borgel/bolton_buttons/mvp3/Linear-MVP3/Linear-MVP3.step

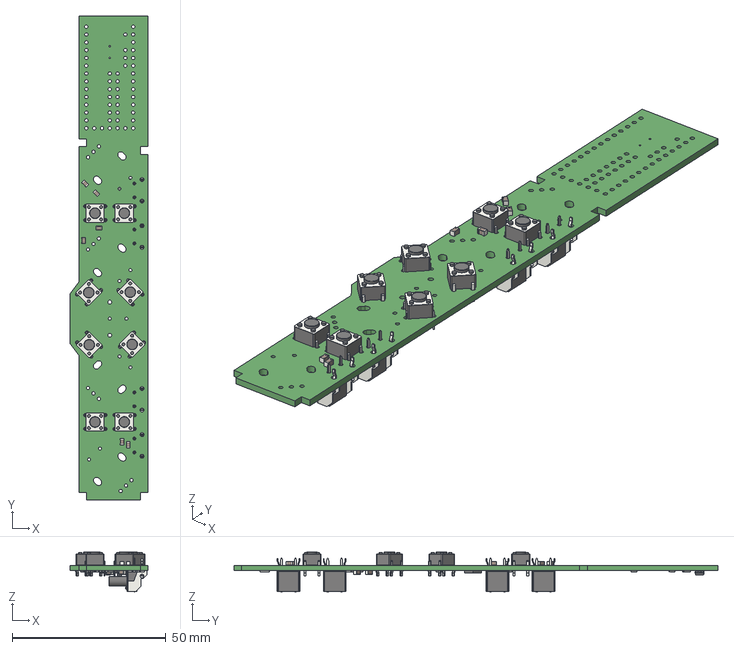
[picture p1: CAD file, 2019-04-27]
mvp3/Linear-MVP3/Linear-MVP3.step
25.5 x 157.5 x 13.0 mm
