borgel/bolton_buttons/mvp1/Dial-MVP2/Dial-MVP2.pdf

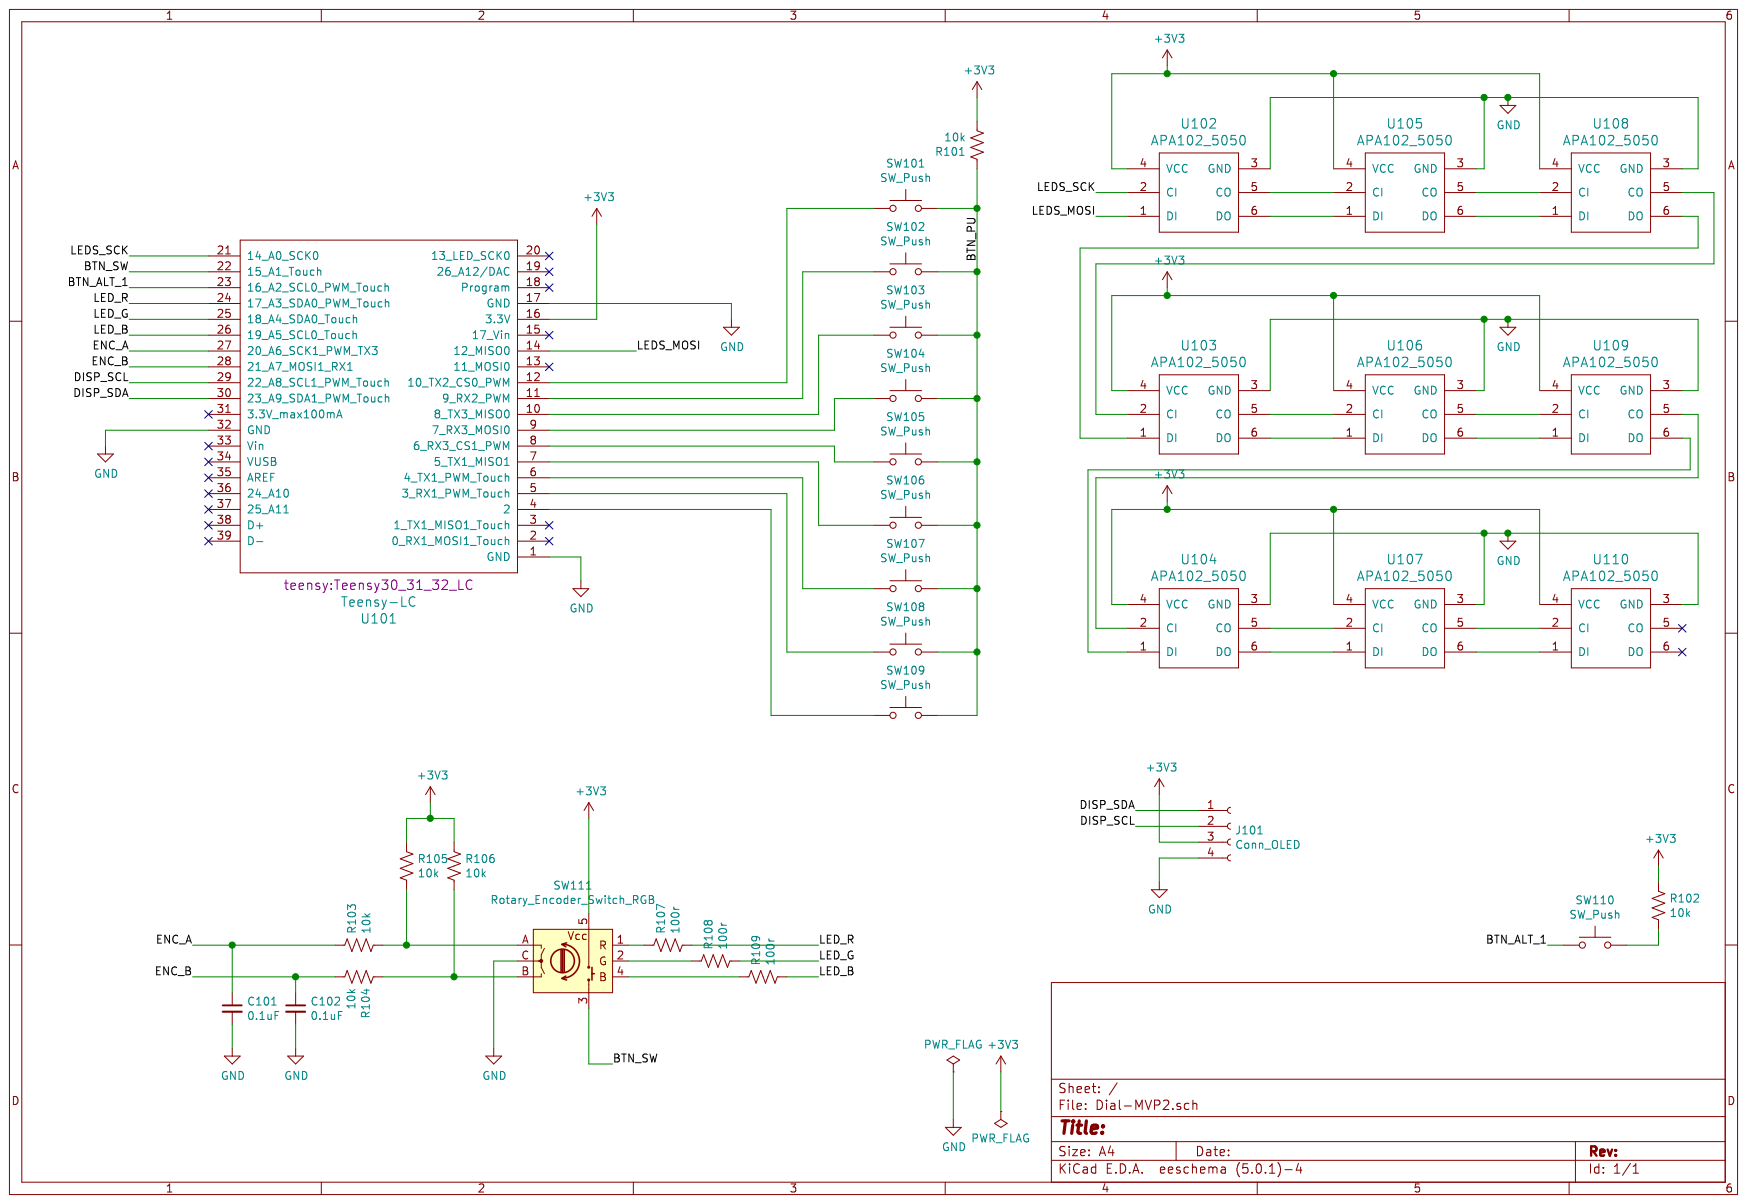
[picture p2: page 1]
