borgel/bolton_buttons/mvp3/Linear-MVP3/Linear-MVP3-Layout.pdf

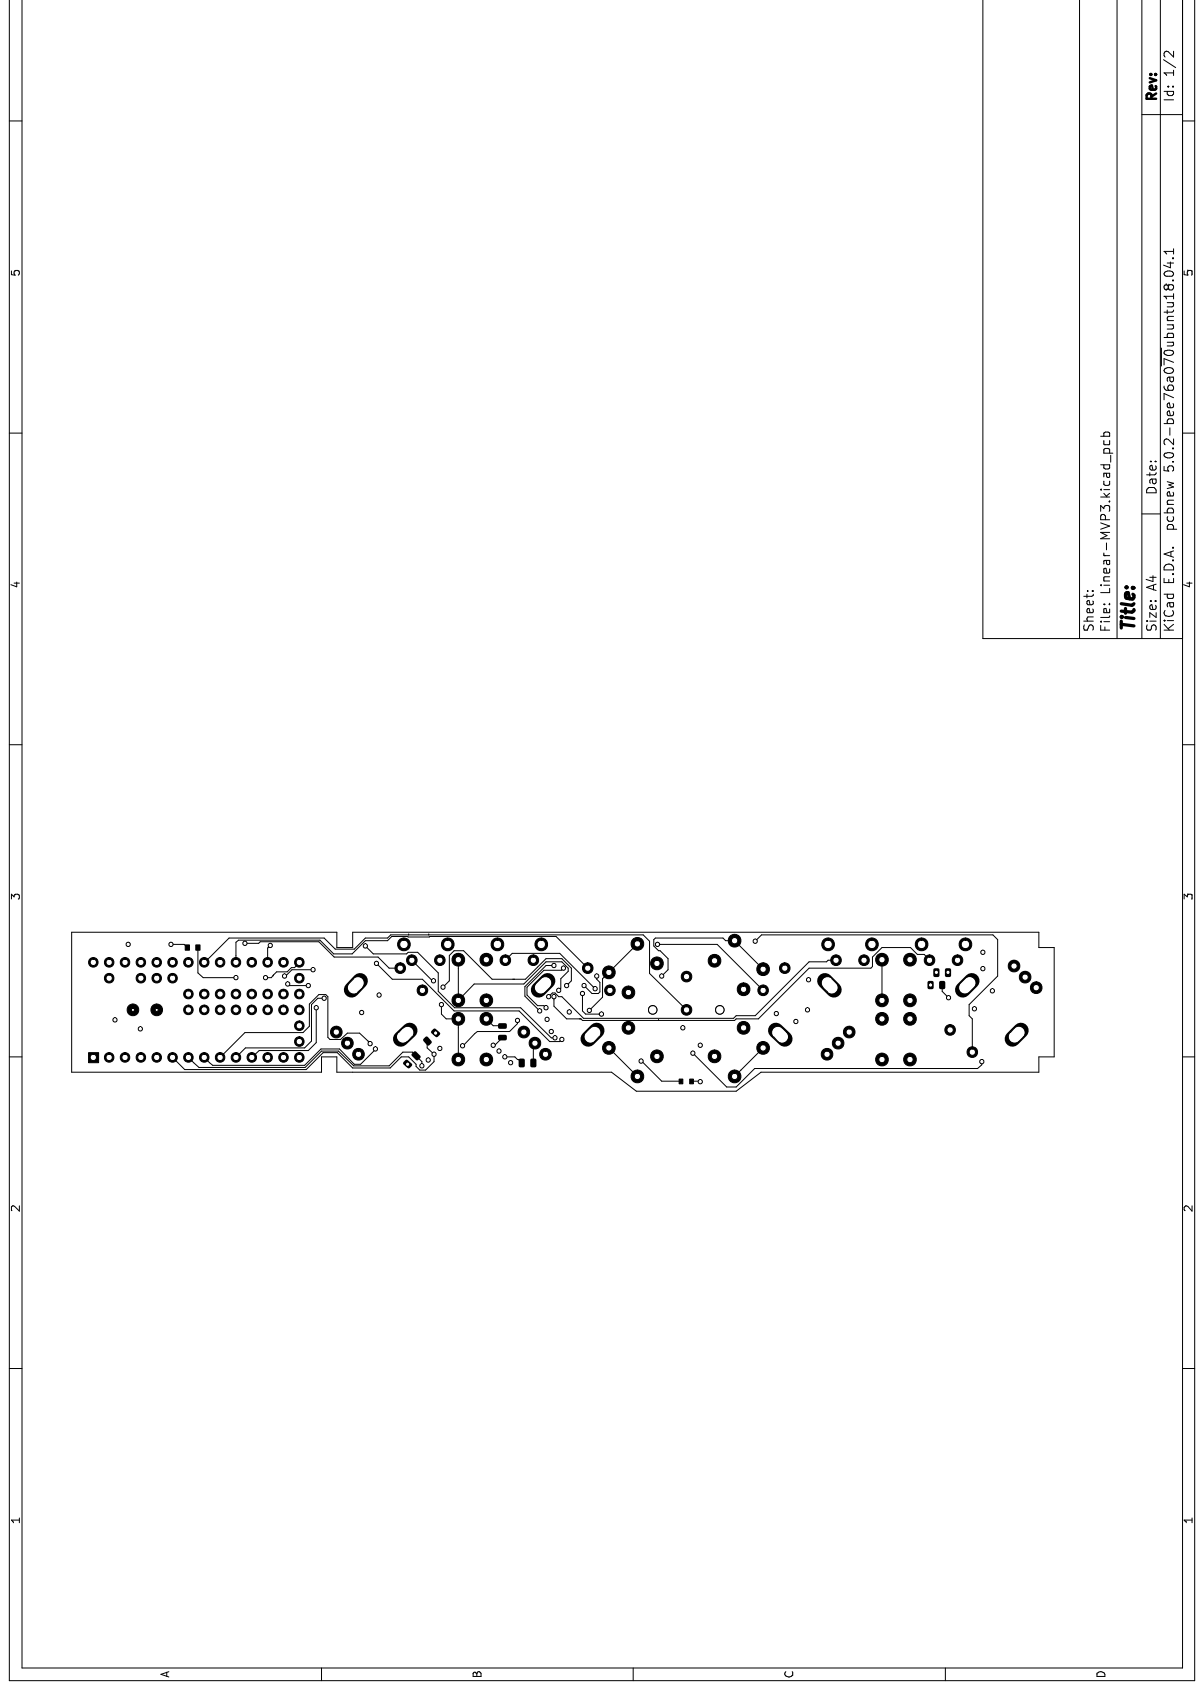
[picture p3: page 1]

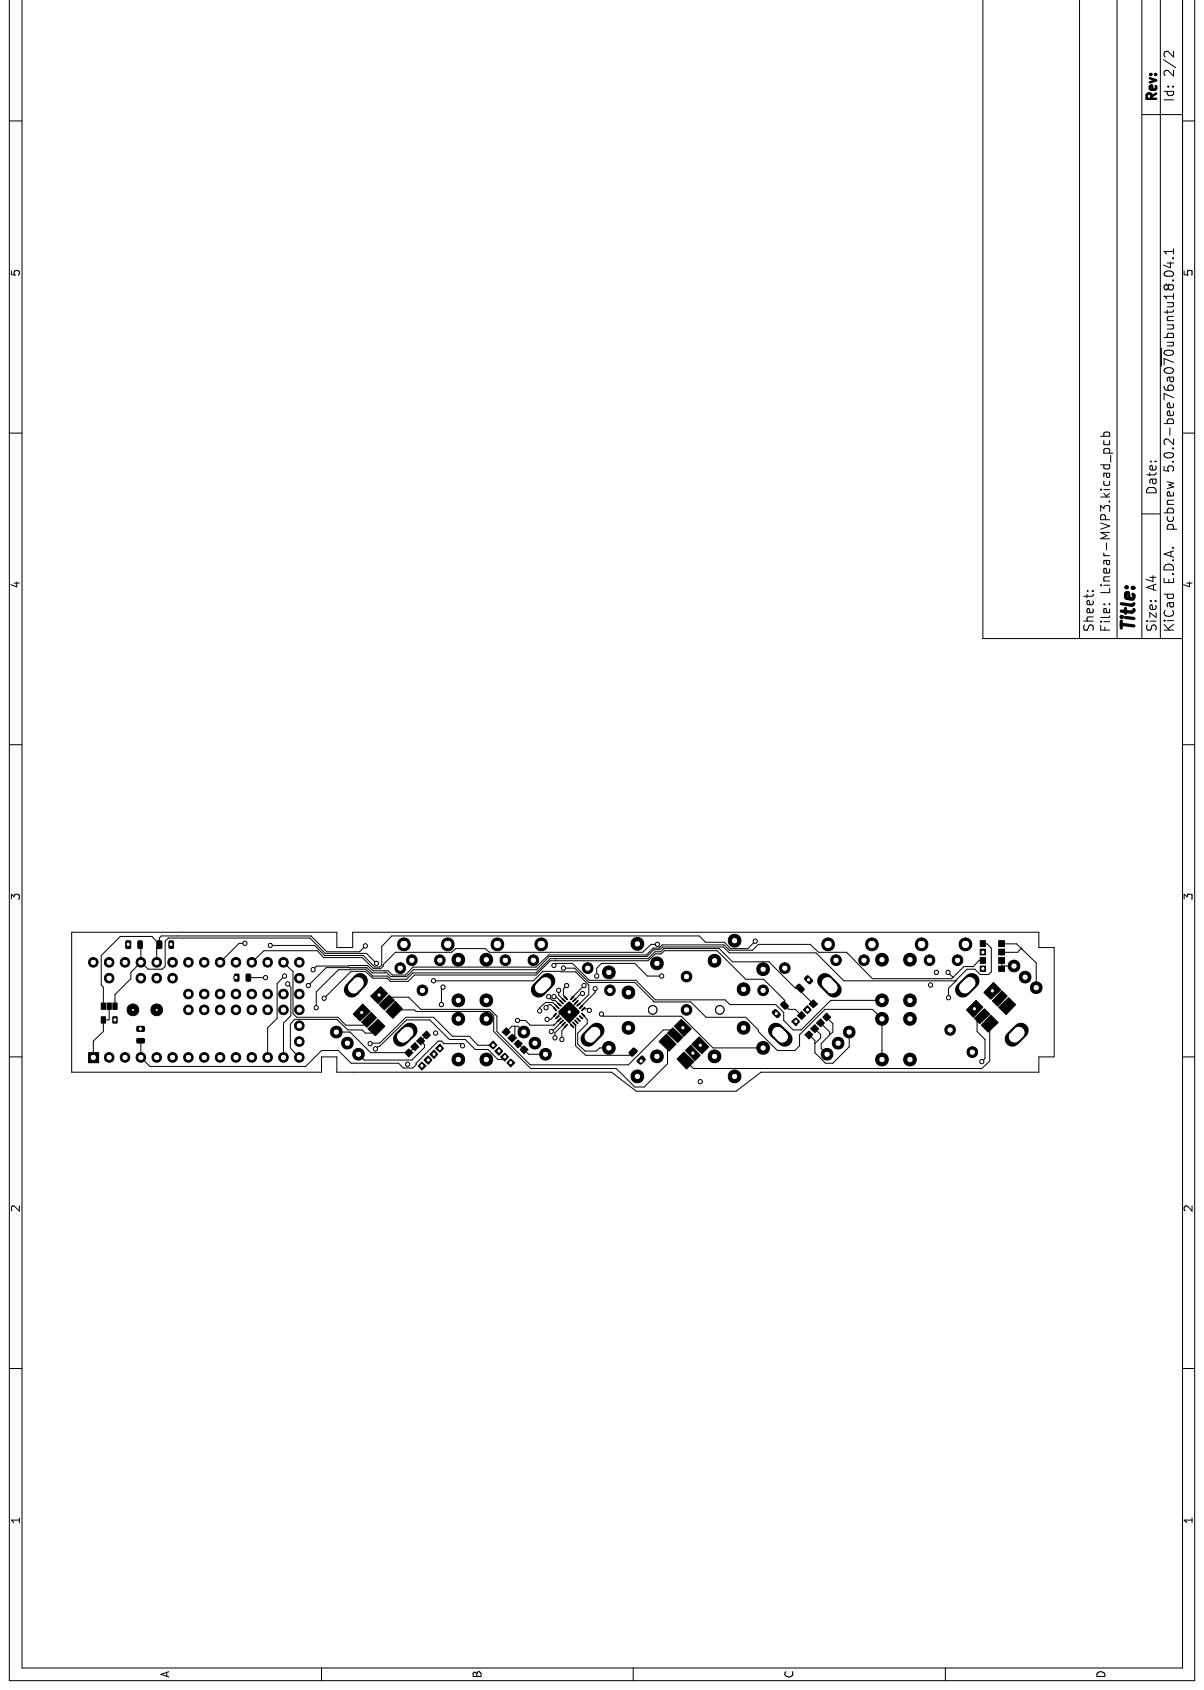
[picture p4: page 2]
