borgel/bolton_buttons/mvp3/Linear-MVP3/Linear-MVP3.pdf

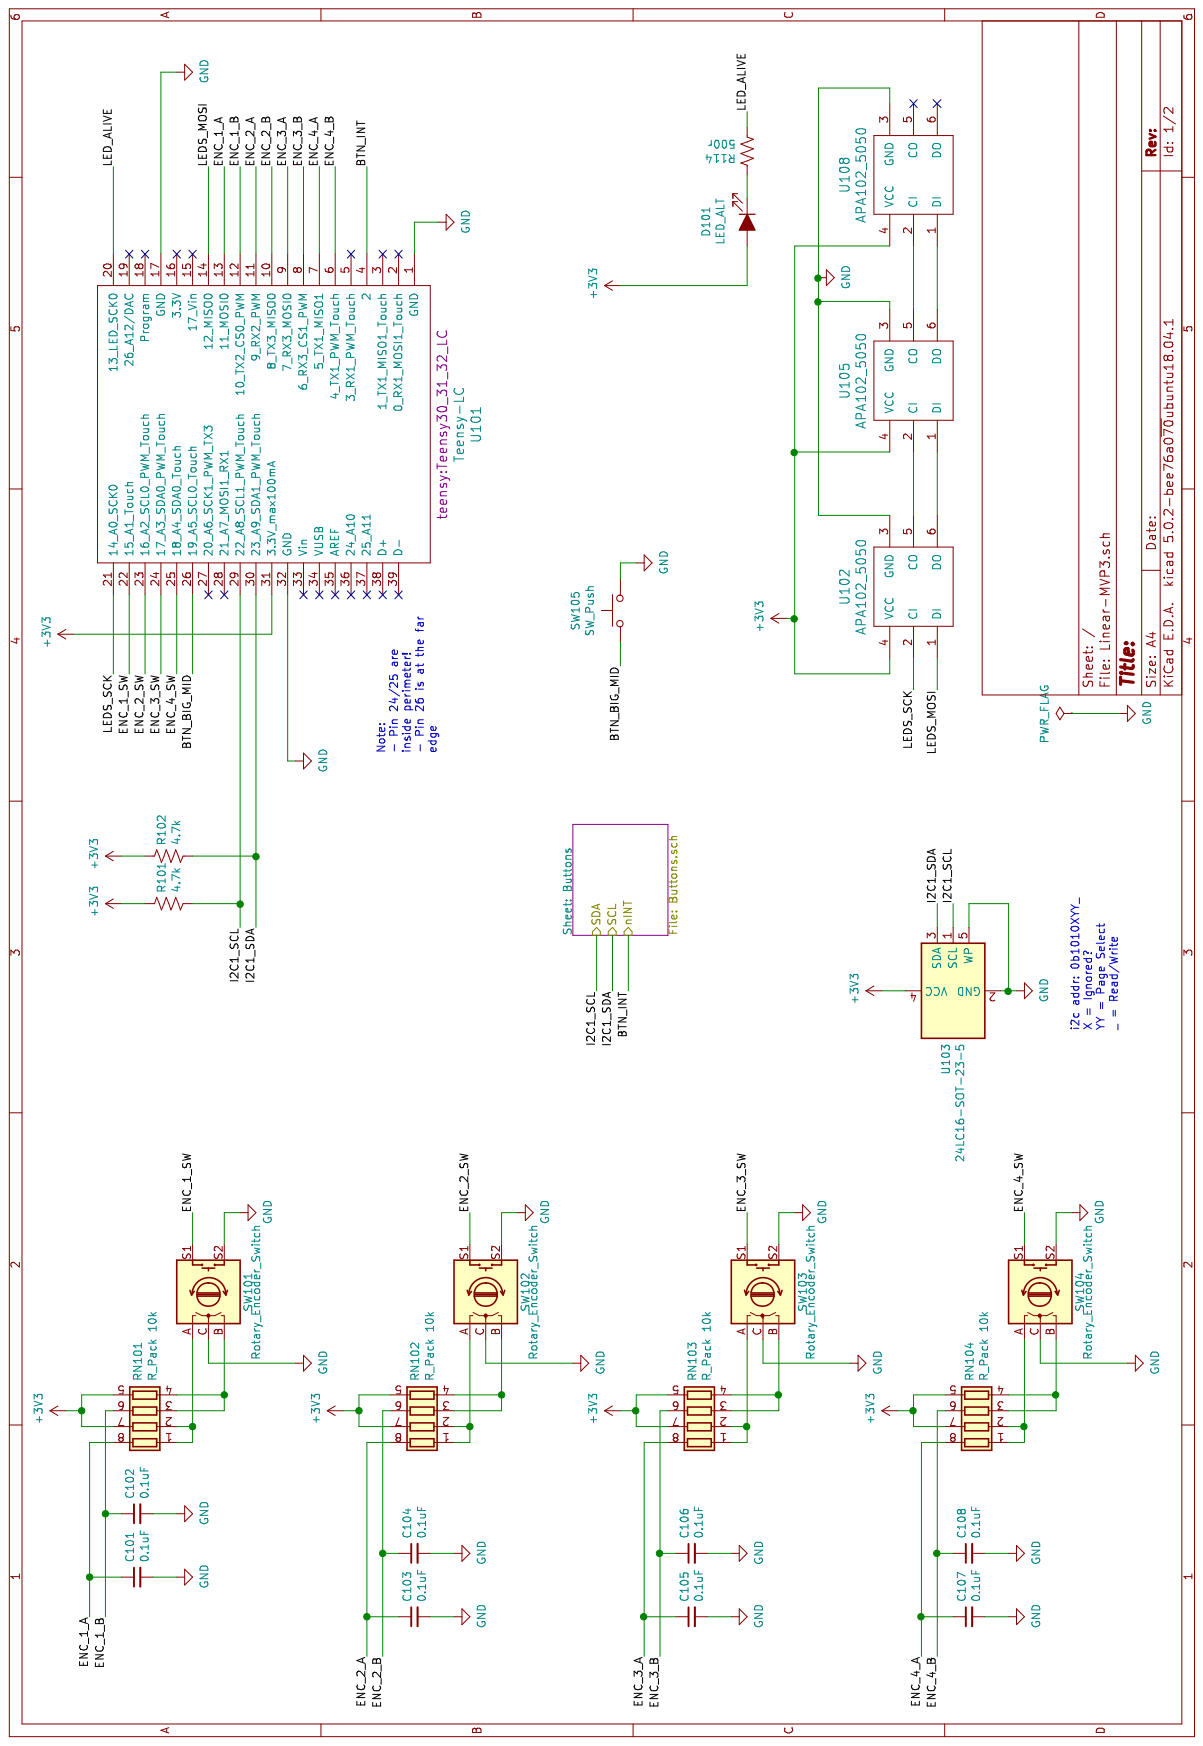
[picture p5: page 1]

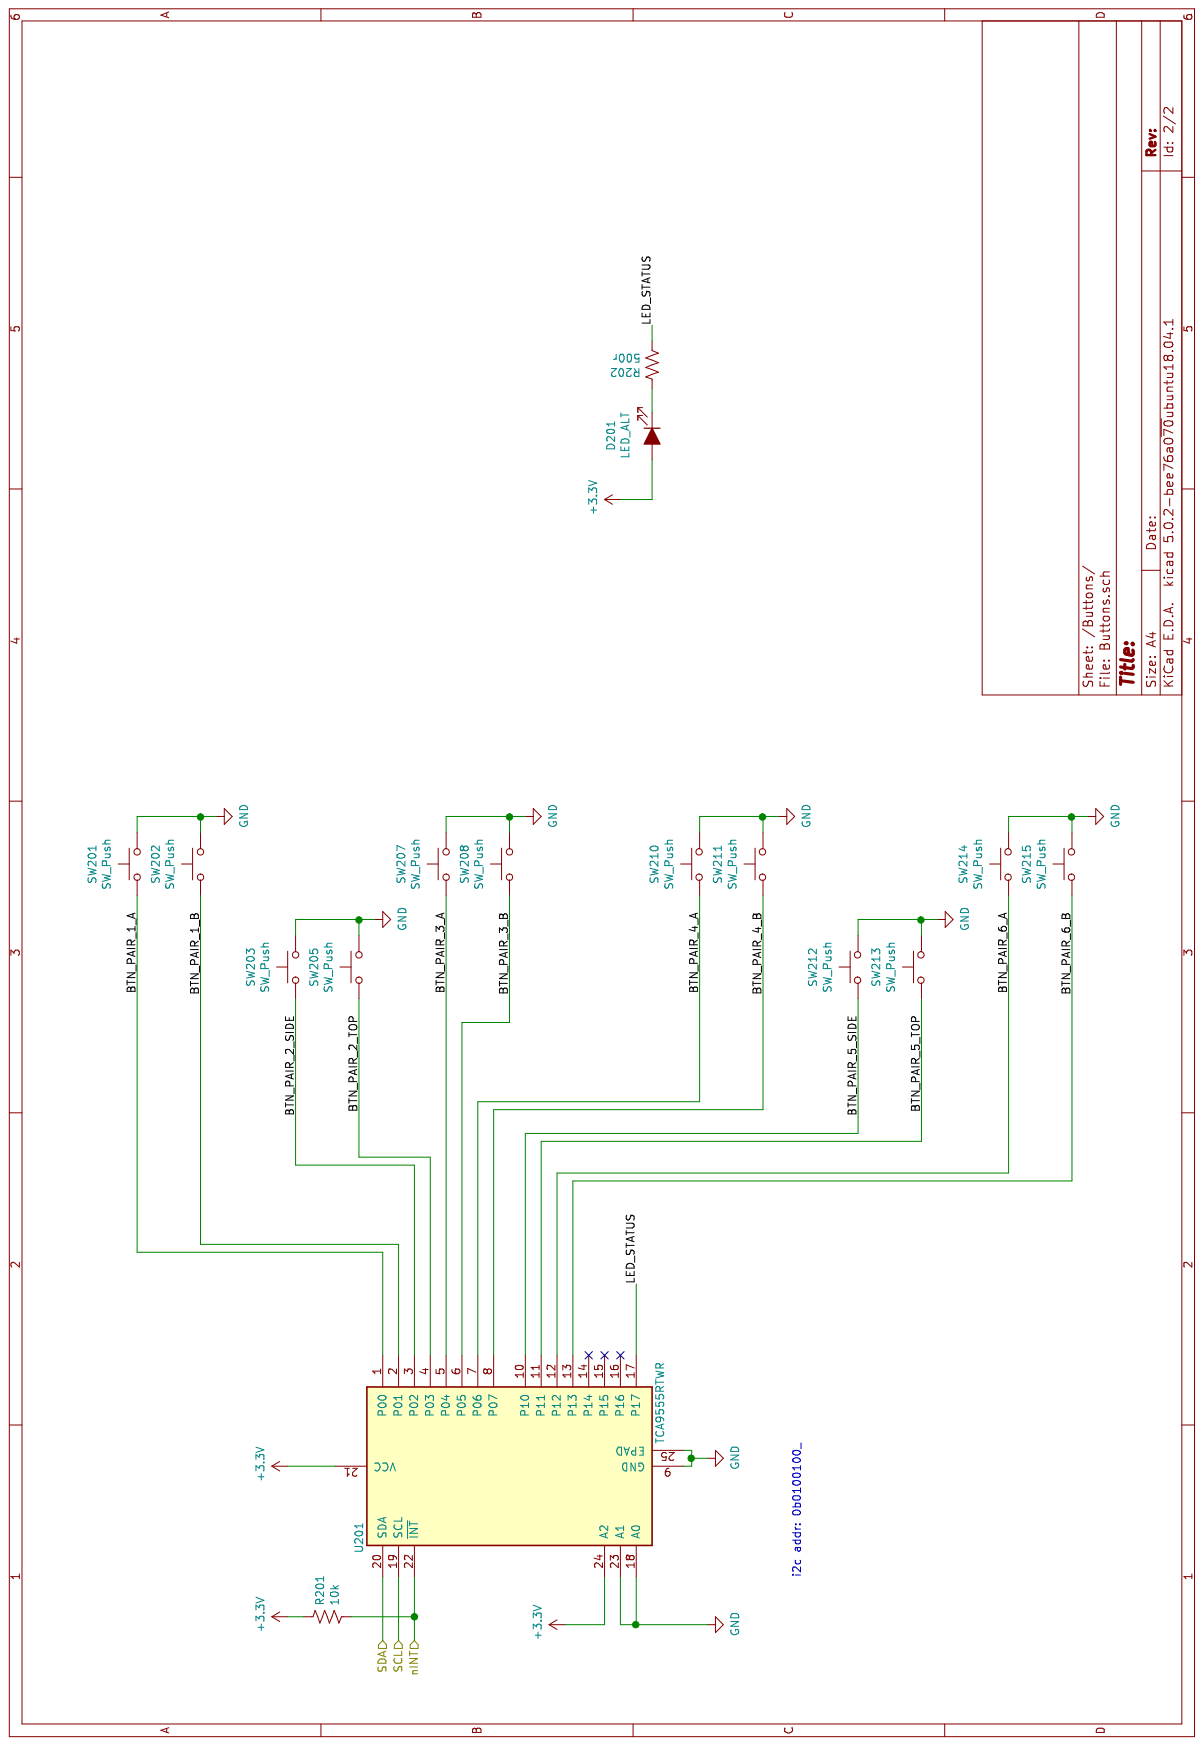
[picture p6: page 2]
