borgel/bolton_buttons/mvp1/Dial-MVP2/Dial-MVP2.kicad_pcb

## KiCad design mvp1/Dial-MVP2/Dial-MVP2.kicad_pcb (2019-04-27)

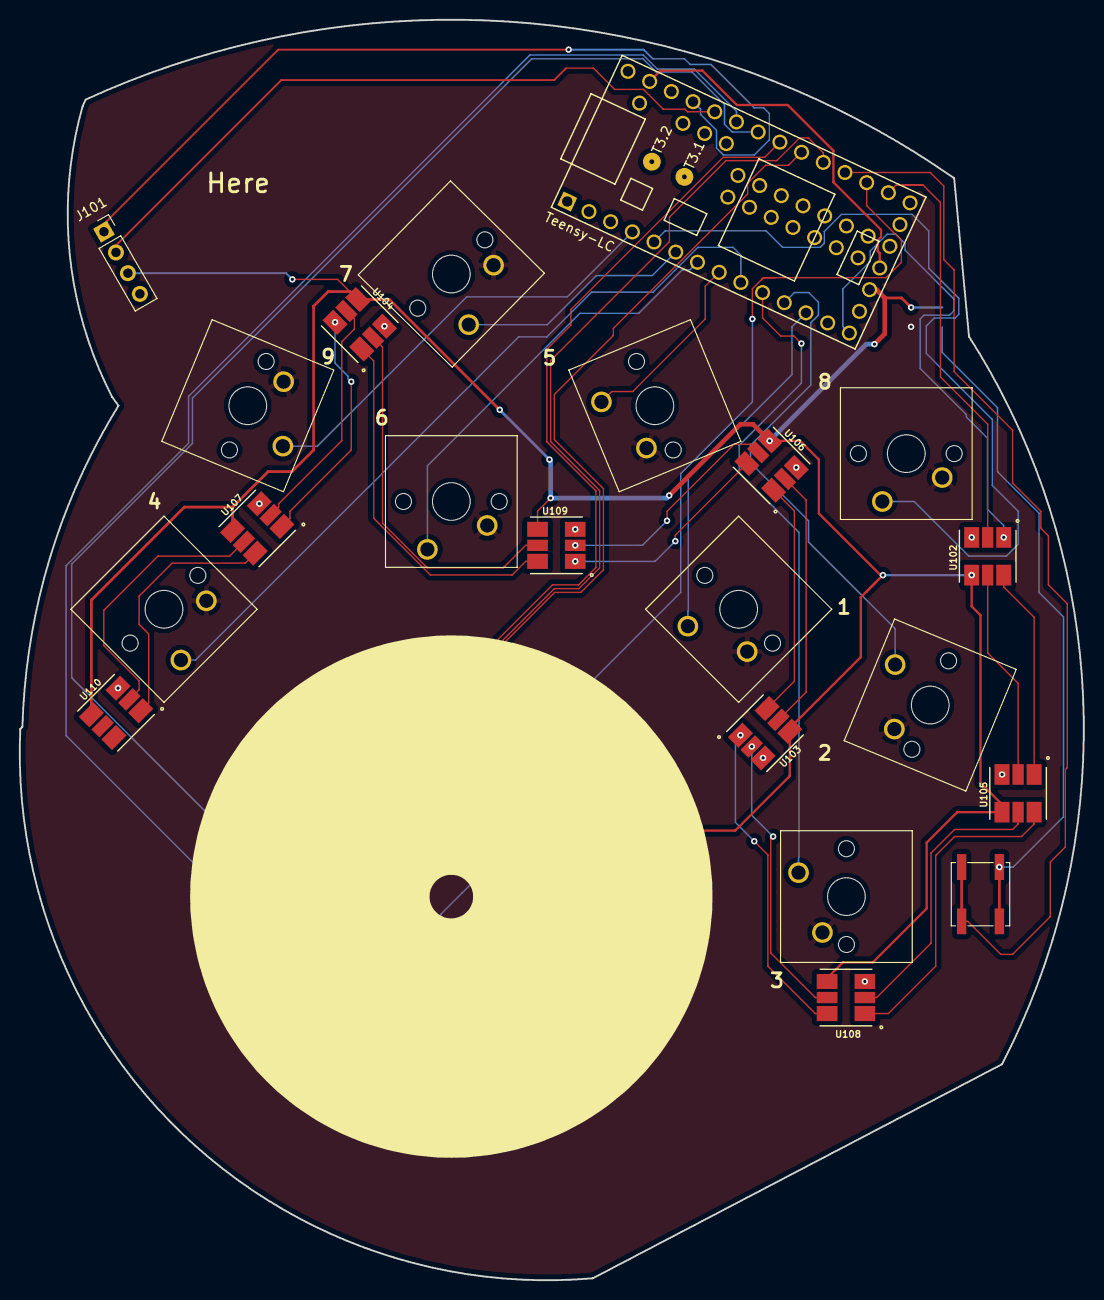
[picture p7: board Dial-MVP2.kicad_pcb from above]

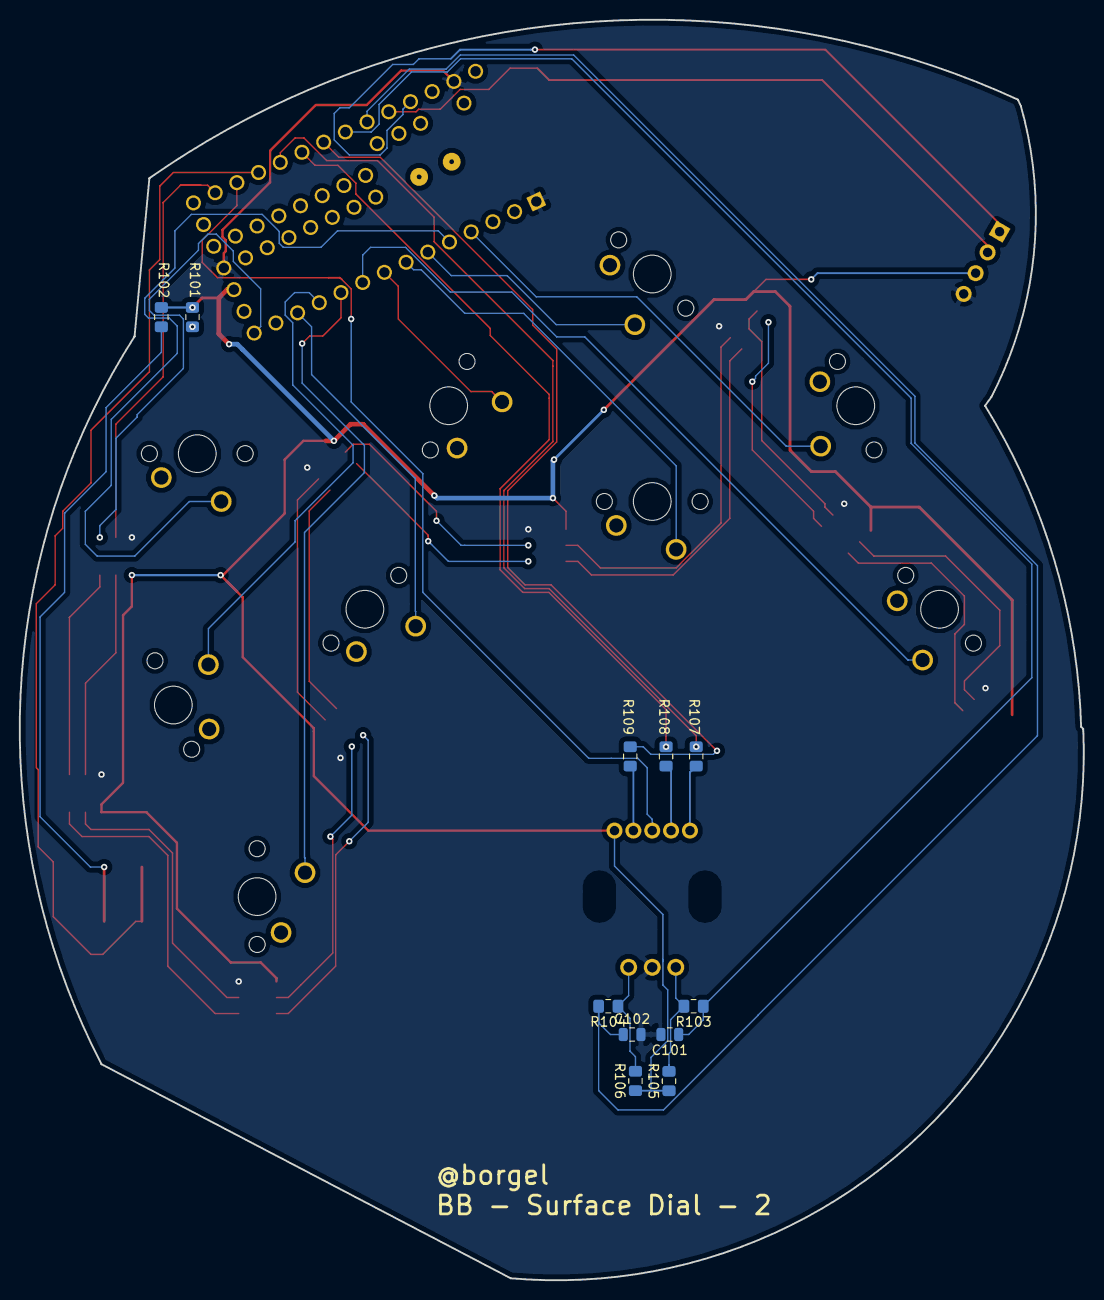
[picture p8: board Dial-MVP2.kicad_pcb from below]

Board: 2 copper layers, 112.9 x 133.7 mm, 33 parts (11 on the bottom side), 45 nets.

Parts:
C101, C102: 0.1uF; C_0805_2012Metric
J101: Conn_OLED; PinSocket_1x04_P2.54mm_Vertical
R101, R102, R103, R104, R105, R106: 10k; R_0805_2012Metric_Pad1.15x1.40mm_HandSolder
R107, R108, R109: 100r; R_0805_2012Metric_Pad1.15x1.40mm_HandSolder
SW101, SW102, SW103, SW104, SW105, SW106, SW107, SW108, SW109: SW_Push; SW_Cherry_MX1A_1.00u_PCB
SW110: SW_Push; SW_SPST_EVQP0
SW111: Rotary_Encoder_Switch_RGB; PEL12T-4xxxF-S1024
U101: Teensy-LC; Teensy30_31_32_LC
U102, U103, U104, U105, U106, U107, U108, U109, U110: APA102_5050; LED-5050

Connections:
+3V3: J101.3, R101.2, R102.1, R105.1, R106.1, SW111.5, U101.16, U102.4, U103.4, U104.4, U105.4, U106.4, U107.4, U108.4, U109.4, U110.4
/BTN_ALT_1: SW110.1, U101.23
/BTN_PU: R101.1, SW101.2, SW102.2, SW103.2, SW104.2, SW105.2, SW106.2, SW107.2, SW108.2, SW109.2
/BTN_SW: SW111.3, U101.22
/DISP_SCL: J101.2, U101.29
/DISP_SDA: J101.1, U101.30
/ENC_A: C101.1, R103.1, U101.27
/ENC_B: C102.1, R104.2, U101.28
/LEDS_MOSI: U101.14, U102.1
/LEDS_SCK: U101.21, U102.2
/LED_B: R109.2, U101.26
/LED_G: R108.2, U101.25
/LED_R: R107.2, U101.24
GND: C101.2, C102.2, J101.4, SW111.C, U101.1, U101.17, U101.32, U102.3, U103.3, U104.3, U105.3, U106.3, U107.3, U108.3, U109.3, U110.3
unnamed: R102.2, SW110.2
unnamed: R103.2, R105.2, SW111.A
unnamed: R104.1, R106.2, SW111.B
unnamed: R107.1, SW111.1
unnamed: R108.1, SW111.2
unnamed: R109.1, SW111.4
unnamed: SW101.1, U101.12
unnamed: SW102.1, U101.11
unnamed: SW103.1, U101.10
unnamed: SW104.1, U101.9
unnamed: SW105.1, U101.8
unnamed: SW106.1, U101.7
unnamed: SW107.1, U101.6
unnamed: SW108.1, U101.5
unnamed: SW109.1, U101.4
unnamed: U102.5, U105.2
unnamed: U102.6, U105.1
unnamed: U103.1, U108.6
unnamed: U103.2, U108.5
unnamed: U103.5, U106.2
unnamed: U103.6, U106.1
unnamed: U104.1, U109.6
unnamed: U104.2, U109.5
unnamed: U104.5, U107.2
unnamed: U104.6, U107.1
unnamed: U105.5, U108.2
unnamed: U105.6, U108.1
unnamed: U106.5, U109.2
unnamed: U106.6, U109.1
unnamed: U107.5, U110.2
unnamed: U107.6, U110.1
