borgel/bolton_buttons/mvp3/Linear-MVP3/Linear-MVP3.kicad_pcb

## KiCad design mvp3/Linear-MVP3/Linear-MVP3.kicad_pcb (2019-04-27)

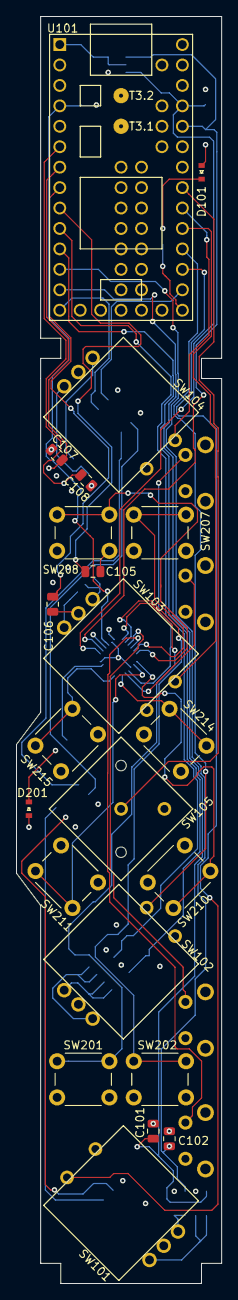
[picture p9: board Linear-MVP3.kicad_pcb from above]

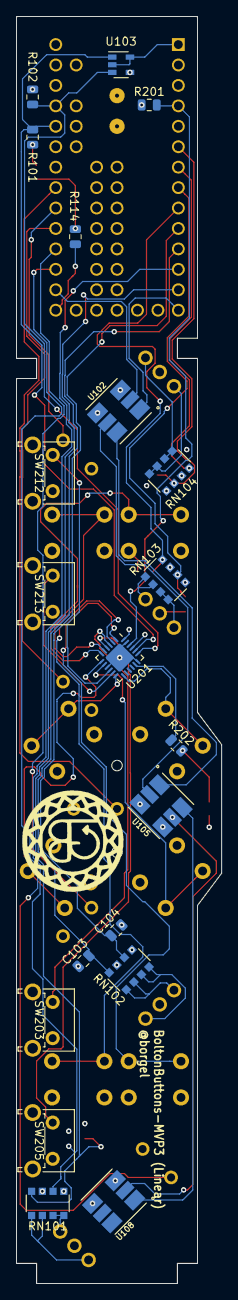
[picture p10: board Linear-MVP3.kicad_pcb from below]

Board: 4 copper layers, 25.5 x 157.5 mm, 42 parts (20 on the bottom side), 48 nets.

Parts:
C101, C102, C103, C104, C105, C106, C107, C108: 0.1uF; C_0805_2012Metric
D101, D201: LED_ALT; LED_0603_SmallSilk
R101, R102: 4.7k; R_0805_2012Metric
R114, R202: 500r; R_0805_2012Metric
R201: 10k; R_0805_2012Metric
RN101, RN102, RN103, RN104: R_Pack 10k; R_Array_Convex_4x1206
SW101, SW102, SW103, SW104: Rotary_Encoder_Switch; PEC11R
SW105: SW_Push; Schurter-MTG
SW201, SW202, SW207, SW208, SW210, SW211, SW214, SW215: SW_Push; SW_PUSH_6mm
SW203, SW205, SW212, SW213: SW_Push; SW_Tactile_SPST_Angled_PTS645Vx83-2LFS
U101: Teensy-LC; Teensy30_31_32_LC
U102, U105, U108: APA102_5050; LED-5050
U103: 24LC16-SOT-23-5; SOT-23-5
U201: TCA9555RTWR; QFN-24-1EP_4x4mm_P0.5mm_EP2.6x2.6mm

Connections:
+3V3: D101.2, D201.2, R101.1, R102.1, R201.1, RN101.5, RN101.7, RN102.5, RN102.7, RN103.5, RN103.7, RN104.5, RN104.7, U101.31, U102.4, U103.4, U105.4, U108.4, U201.21, U201.24
/BTN_BIG_MID: SW105.1, U101.26
/BTN_INT: R201.2, U101.4, U201.22
/Buttons/BTN_PAIR_1_A: SW201.1, U201.1
/Buttons/BTN_PAIR_1_B: SW202.1, U201.2
/Buttons/BTN_PAIR_2_SIDE: SW203.1, U201.3
/Buttons/BTN_PAIR_2_TOP: SW205.1, U201.4
/Buttons/BTN_PAIR_3_A: SW207.1, U201.5
/Buttons/BTN_PAIR_3_B: SW208.1, U201.6
/Buttons/BTN_PAIR_4_A: SW210.1, U201.7
/Buttons/BTN_PAIR_4_B: SW211.1, U201.8
/Buttons/BTN_PAIR_5_SIDE: SW212.1, U201.10
/Buttons/BTN_PAIR_5_TOP: SW213.1, U201.11
/Buttons/BTN_PAIR_6_A: SW214.1, U201.12
/Buttons/BTN_PAIR_6_B: SW215.1, U201.13
/Buttons/LED_STATUS: R202.2, U201.17
/ENC_1_A: C101.1, RN101.8, U101.13
/ENC_1_B: C102.1, RN101.6, U101.12
/ENC_1_SW: SW101.S1, U101.22
/ENC_2_A: C103.1, RN102.8, U101.11
/ENC_2_B: C104.1, RN102.6, U101.10
/ENC_2_SW: SW102.S1, U101.23
/ENC_3_A: C105.1, RN103.8, U101.9
/ENC_3_B: C106.1, RN103.6, U101.8
/ENC_3_SW: SW103.S1, U101.24
/ENC_4_A: C107.1, RN104.8, U101.7
/ENC_4_B: C108.1, RN104.6, U101.6
/ENC_4_SW: SW104.S1, U101.25
/I2C1_SCL: R101.2, U101.29, U103.1, U201.20
/I2C1_SDA: R102.2, U101.30, U103.3, U201.19
/LEDS_MOSI: U101.14, U102.1
/LEDS_SCK: U101.21, U102.2
/LED_ALIVE: R114.2, U101.20
GND: C101.2, C102.2, C103.2, C104.2, C105.2, C106.2, C107.2, C108.2, SW101.C, SW101.S2, SW102.C, SW102.S2, SW103.C, SW103.S2, SW104.C, SW104.S2, SW105.2, SW201.2, SW202.2, SW203.2, SW205.2, SW207.2, SW208.2, SW210.2, SW211.2, SW212.2, SW213.2, SW214.2, SW215.2, U101.1, U101.17, U101.32, U102.3, U103.2, U103.5, U105.3, U108.3, U201.9, U201.18, U201.23, U201.25
unnamed: D101.1, R114.1
unnamed: D201.1, R202.1
unnamed: RN101.1, RN101.2, SW101.A
unnamed: RN101.3, RN101.4, SW101.B
unnamed: RN102.1, RN102.2, SW102.A
unnamed: RN102.3, RN102.4, SW102.B
unnamed: RN103.1, RN103.2, SW103.A
unnamed: RN103.3, RN103.4, SW103.B
unnamed: RN104.1, RN104.2, SW104.A
unnamed: RN104.3, RN104.4, SW104.B
unnamed: U102.5, U105.2
unnamed: U102.6, U105.1
unnamed: U105.5, U108.2
unnamed: U105.6, U108.1
