borgel/bolton_buttons/mvp3/bolton_buttons_mvp3/TCA9555.cpp

/*
* TCA9555 Library
* Kerry D. Wong
* http://www.kerrywong.com
* 3/2011
*/

#include "TCA9555.h"
#include <i2c_t3.h>
#include <stdint.h>

//a2, a1 and a0 are the address pin states
//they can be either 0 or 1 (low or high)
//the actual I2C address is calculated using 
//the pin settings.
TCA9555::TCA9555(byte a2, byte a1, byte a0)
{
  A2 = a2;
  A1 = a1;
  A0 = a0;
	
  I2CAddr = 0x20 | (A2 << 2 | A1 << 1 | A0);	
}

//set port directions for both ports
//dir: DIR_OUTPUT or DIR_INPUT
void TCA9555::setPortDirection(byte dir)
{
  Wire1.beginTransmission(I2CAddr);
  Wire1.send(CR_CFG0);
  Wire1.send(dir);
  Wire1.send(dir);
  Wire1.endTransmission();	
}

//portNum: PORT_0 or PORT_1
void TCA9555::setPortDirection(byte portNum, byte dir)
{
  Wire1.beginTransmission(I2CAddr);
  if (portNum == PORT_0) Wire1.send(CR_CFG0);
  else Wire1.send(CR_CFG1);
  Wire1.send(dir);
  Wire1.endTransmission();
}

//set port polarity for both ports
//polarity: POLARITY_NORMAL or POLARITY_INV
void TCA9555::setPortPolarity(byte polarity)
{
  Wire1.beginTransmission(I2CAddr);
  Wire1.send(CR_INV0);
  Wire1.send(polarity);
  Wire1.send(polarity);
  Wire1.endTransmission();
}

void TCA9555::setPortPolarity(byte portNum, byte polarity)
{
  Wire1.beginTransmission(I2CAddr);
  if (portNum == PORT_0) Wire1.send(CR_INV0);
  else Wire1.send(CR_INV1);
  Wire1.send(polarity);
  Wire1.endTransmission();
}

//set output states when both ports are used as output ports
//w contains all 16 ports' states.
void TCA9555::setOutputStates(word w)
{
  byte low_byte = w & 0xff;
  byte high_byte = (w & 0xff00) >> 8;

  Wire1.beginTransmission(I2CAddr);
  Wire1.send(CR_OUT0);
  Wire1.send(low_byte);
  Wire1.send(high_byte);
  Wire1.endTransmission();
}

void TCA9555::setOutputStates(byte portNum, byte b)
{
  Wire1.beginTransmission(I2CAddr);
  if (portNum == PORT_0) Wire1.send(CR_OUT0);
  else Wire1.send(CR_OUT1);
  Wire1.send(b);
  Wire1.endTransmission();
}

//returns the input states of both ports when ports
//are used as inputs
uint16_t TCA9555::getInputStates()
{
  byte low_byte, high_byte;

  Wire1.beginTransmission(I2CAddr);
  Wire1.send(0x0);
  Wire1.endTransmission(I2C_NOSTOP);
  
  // request read 2 bytes
  Wire1.requestFrom(I2CAddr, 2u, I2C_STOP);

  while (!Wire1.available()) {};
  low_byte = Wire1.receive();
  while (!Wire1.available()) {};
  high_byte = Wire1.receive();

  Wire1.endTransmission();
  
  uint16_t w = low_byte | (high_byte << 8);
  
  return w;
}

byte TCA9555::getInputStates(byte portNum)
{
  word w = getInputStates();
  
  if (portNum == PORT_0) return w & 0xff;
  else return (w & 0xff00) >> 8;
}
