borgel/bolton_buttons/(commit log)

2018-12-04 Arduino Stub
2018-12-04 Begin button array to config process
2018-12-06 Get LEDs working
2018-12-06 Add basic button reading and debounce
2018-12-06 Update button map to label what is what
2018-12-06 Simplify keyboard
    https://www.pjrc.com/teensy/td_keyboard.html
2018-12-06 Light the LED for the pressed key
2018-12-08 Factor keymap out from physical buttons
2018-12-08 Support multiple keymaps and switch between them
2018-12-10 Add encoder support
2018-12-10 Add test code for the rotary encoder
2019-03-06 Hardware TCA lib to work with Teensy LC
2019-03-06 Fix TCA lib not properly requesting reads
    [TCA9555.cpp]
2019-03-06 Configure and read some buttons via IO expander
2019-03-06 Read all buttons via expander
2019-03-06 Fire an interrupt on button press
2019-03-06 Add LED strip test code
2019-03-07 Add modified IO expander driver
2019-03-07 Wire encoder buttons through keyboard code
2019-03-07 Track all knobs for changes
2019-03-07 Calculate and track knob change
2019-03-07 Add big center direct button
2019-03-07 Add a module to track changes on the IO expander and fire a CB for them
2019-03-07 Integrate IO expander buttons into main loop
2019-03-08 Rework keymaps, enable all buttons and knobs thru maps
    [ExpanderButton.cpp, bolton_buttons_mvp3.ino, buttonmap.h]
2019-03-08 Make middle button press esc
2019-03-08 Label buttons in logical map
2019-03-08 Swap pairs around middle button
    [buttonmap.h]
2019-04-27 Add hardware files for V2 (listed as v1 here) and V3
    [Buttons.sch, Dial-MVP2.kicad_pcb, Dial-MVP2.sch, Linear-MVP3.csv, Linear-MVP3.kicad_pcb, Linear-MVP3.sch, Linear-MVP3.step]
